knielsen/pcb_ledtorus_controller/pcb_ledtorus_controller.kicad_pcb

## KiCad design pcb_ledtorus_controller.kicad_pcb (2019-06-02)

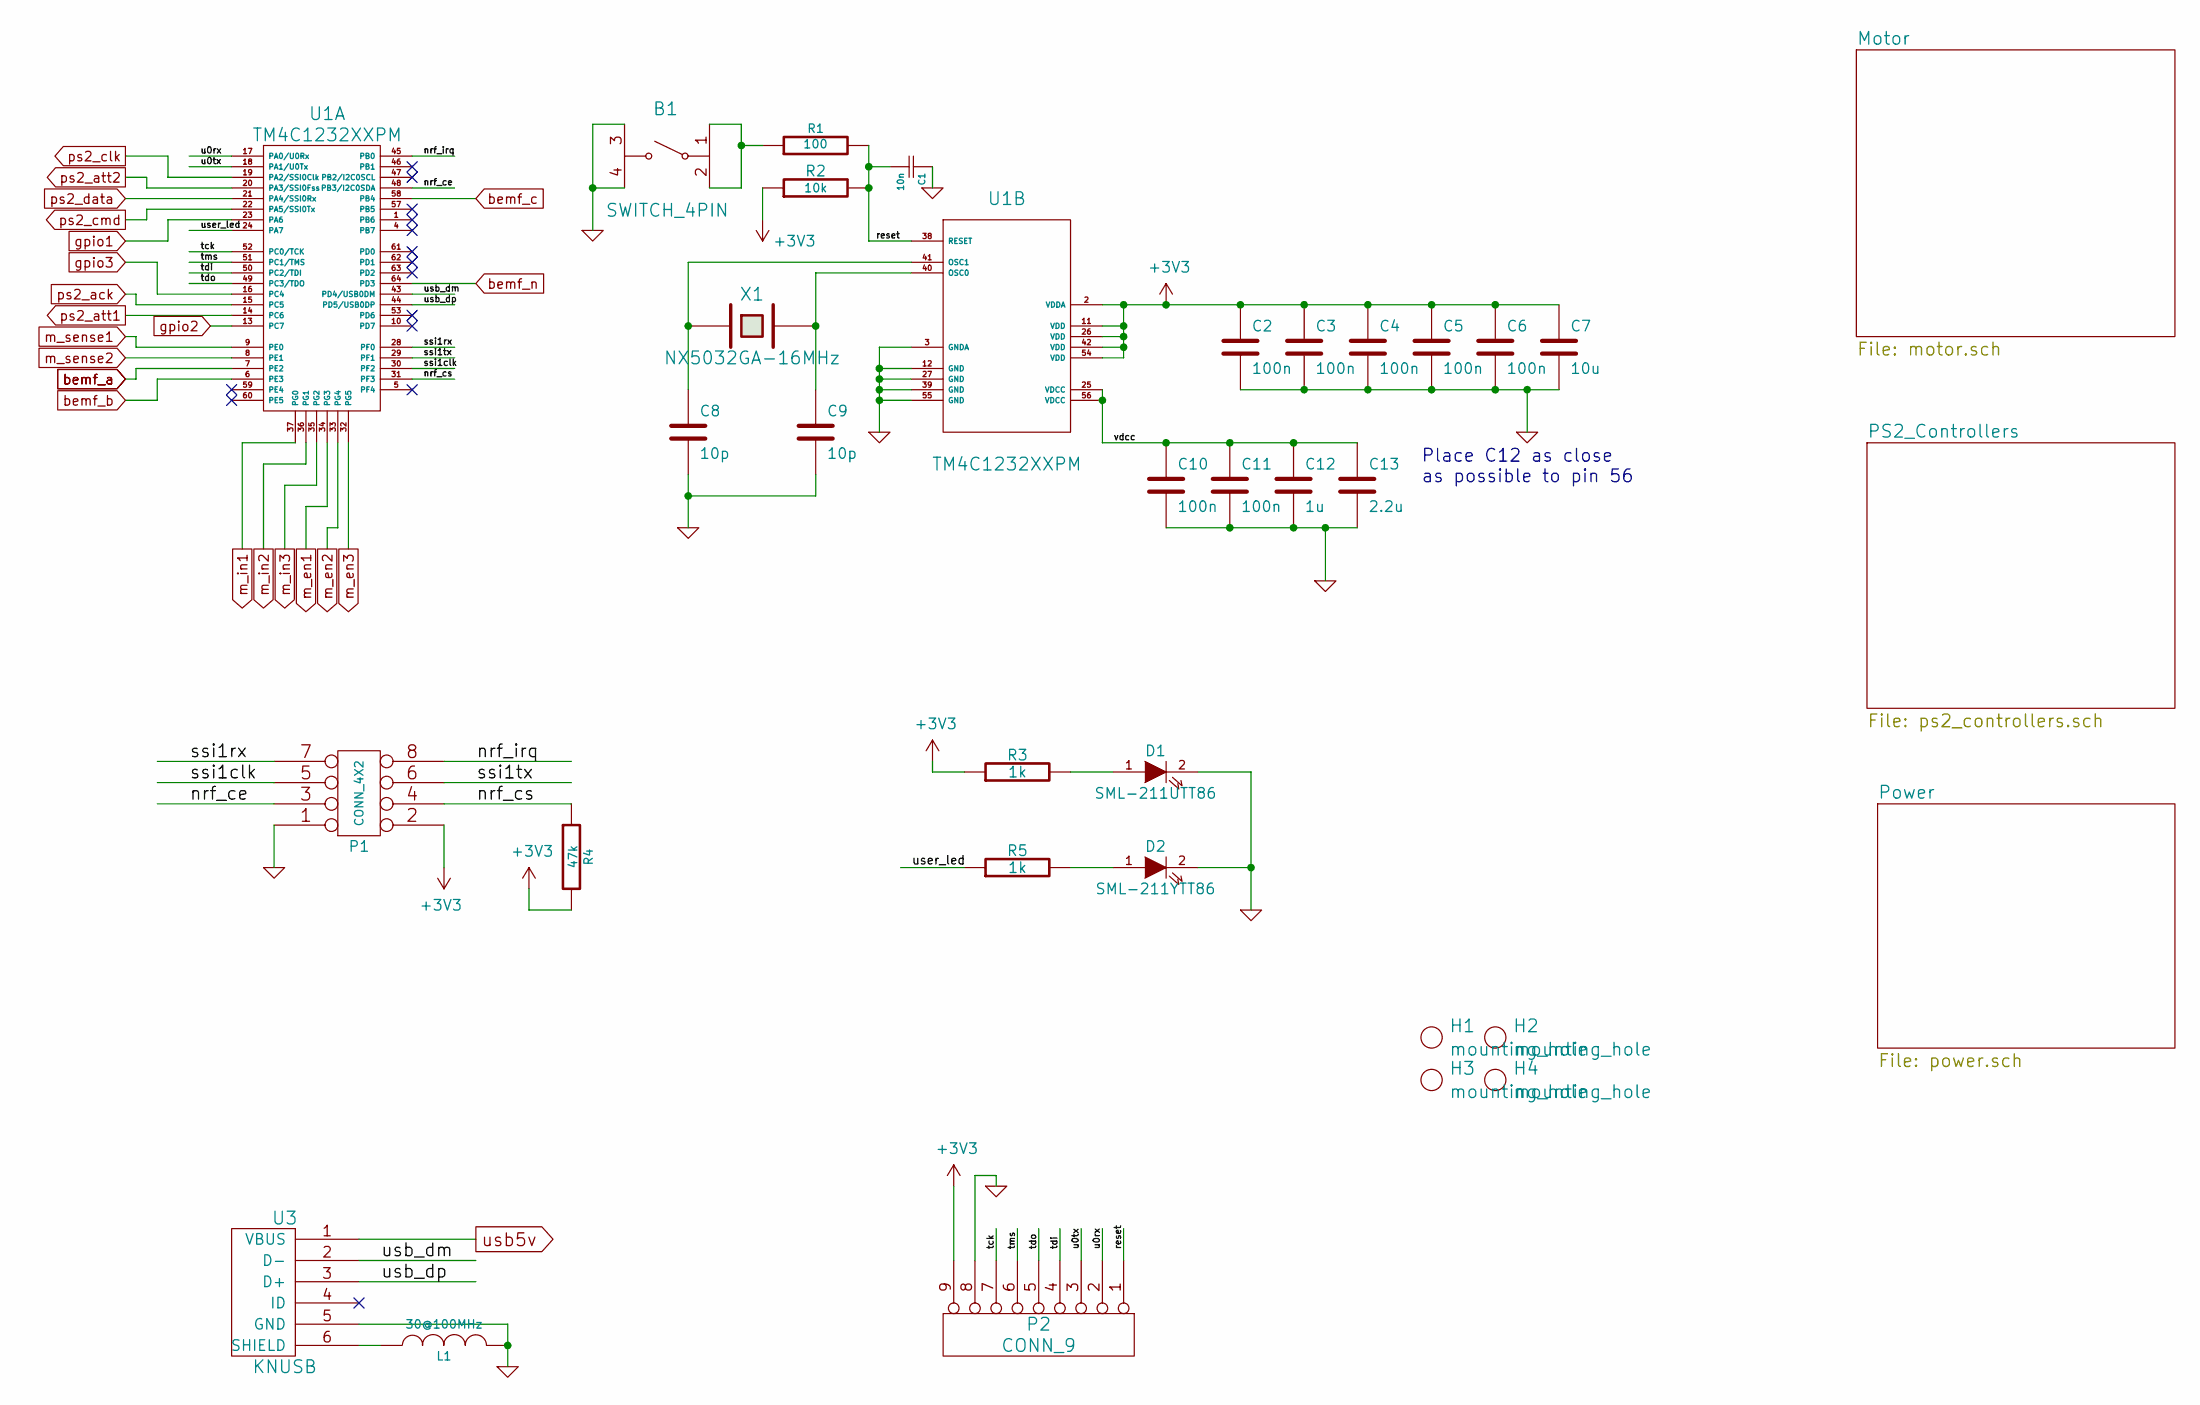
[picture p1: schematic pcb_ledtorus_controller.sch]

Parts:
B1: SWITCH_4PIN; SWITCH_FSMJSMA
C1: 10n; C_0805
C2, C3, C4, C5, C6, C10, C11: 100n; C_0603
C7: 10u; C_0805
C8, C9: 10p; C_0805
C12: 1u; C_0805
C13: 2.2u; C_0805
D1: SML-211UTT86; LED_0805
D2: SML-211YTT86; LED_0805
H1, H2, H3, H4: mounting_hole; MountingHole_4.3mm_M4
L1: 30@100MHz; L_0603
P1: CONN_4X2; Pin_Header_Straight_2x04_Pitch2.54mm
P2: CONN_9; Pin_Header_Straight_1x09_Pitch2.54mm
R1: 100; R_0805
R2: 10k; R_0805
R3, R5: 1k; R_0805
R4: 47k; R_0805
U1: TM4C1232XXPM; LQFP_64
U3: KNUSB; 10103594-0001LF
X1: NX5032GA-16MHz; NX5032GA

Connections:
+3V3: C2.1, C3.1, C4.1, C5.1, C6.1, C7.1, P1.2, P2.9, R2.1, R3.1, R4.2, U1.2 (VDDA), U1.11 (VDD), U1.26 (VDD), U1.42 (VDD), U1.54 (VDD); also elsewhere on the board
/nrf_ce: P1.3, U1.48 (PB3/I2C0SDA)
/nrf_cs: P1.4, R4.1, U1.31 (PF3)
/nrf_irq: P1.8, U1.45 (PB0)
/reset: C1.2, P2.1, R1.2, R2.2, U1.38 (RESET)
/ssi1clk: P1.5, U1.30 (PF2)
/ssi1rx: P1.7, U1.28 (PF0)
/ssi1tx: P1.6, U1.29 (PF1)
/tck: P2.7, U1.52 (PC0/TCK)
/tdi: P2.4, U1.50 (PC2/TDI)
/tdo: P2.5, U1.49 (PC3/TDO)
/tms: P2.6, U1.51 (PC1/TMS)
/u0rx: P2.2, U1.17 (PA0/U0Rx)
/u0tx: P2.3, U1.18 (PA1/U0Tx)
/usb_dm: U1.43 (PD4/USB0DM), U3.2 (D-)
/usb_dp: U1.44 (PD5/USB0DP), U3.3 (D+)
/user_led: R5.1, U1.24 (PA7)
/vdcc: C10.1, C11.1, C12.1, C13.1, U1.25 (VDCC), U1.56 (VDCC)
GND: B1.3, B1.4, C1.1, C2.2, C3.2, C4.2, C5.2, C6.2, C7.2, C8.2, C9.2, C10.2, C11.2, C12.2, C13.2, D1.2 (K), D2.2 (K), L1.2, P1.1, P2.8, U1.3 (GNDA), U1.12 (GND), U1.27 (GND), U1.39 (GND), U1.55 (GND), U3.5 (GND); also elsewhere on the board
unnamed: B1.1, B1.2, R1.1
unnamed: C8.1, U1.41 (OSC1), X1.1
unnamed: C9.1, U1.40 (OSC0), X1.2
unnamed: D1.1 (A), R3.2
unnamed: D2.1 (A), R5.2
unnamed: L1.1, U3.6 (SHIELD)
bemf_a: U1.7 (PE2); also elsewhere on the board
bemf_b: U1.6 (PE3); also elsewhere on the board
bemf_c: U1.58 (PB4); also elsewhere on the board
bemf_n: U1.64 (PD3); also elsewhere on the board
gpio1: U1.23 (PA6); also elsewhere on the board
gpio2: U1.13 (PC7); also elsewhere on the board
gpio3: U1.16 (PC4); also elsewhere on the board
m_en1: U1.34 (PG3); also elsewhere on the board
m_en2: U1.33 (PG4); also elsewhere on the board
m_en3: U1.32 (PG5); also elsewhere on the board
m_in1: U1.37 (PG0); also elsewhere on the board
m_in2: U1.36 (PG1); also elsewhere on the board
m_in3: U1.35 (PG2); also elsewhere on the board
m_sense1: U1.9 (PE0); also elsewhere on the board
m_sense2: U1.8 (PE1); also elsewhere on the board
ps2_ack: U1.15 (PC5); also elsewhere on the board
ps2_att1: U1.14 (PC6); also elsewhere on the board
ps2_att2: U1.20 (PA3/SSI0Fss); also elsewhere on the board
ps2_clk: U1.19 (PA2/SSI0Clk); also elsewhere on the board
ps2_cmd: U1.22 (PA5/SSI0Tx); also elsewhere on the board
ps2_data: U1.21 (PA4/SSI0Rx); also elsewhere on the board
usb5v: U3.1 (VBUS); also elsewhere on the board

Notes on the sheet:
Place C12 as close as possible to pin 56

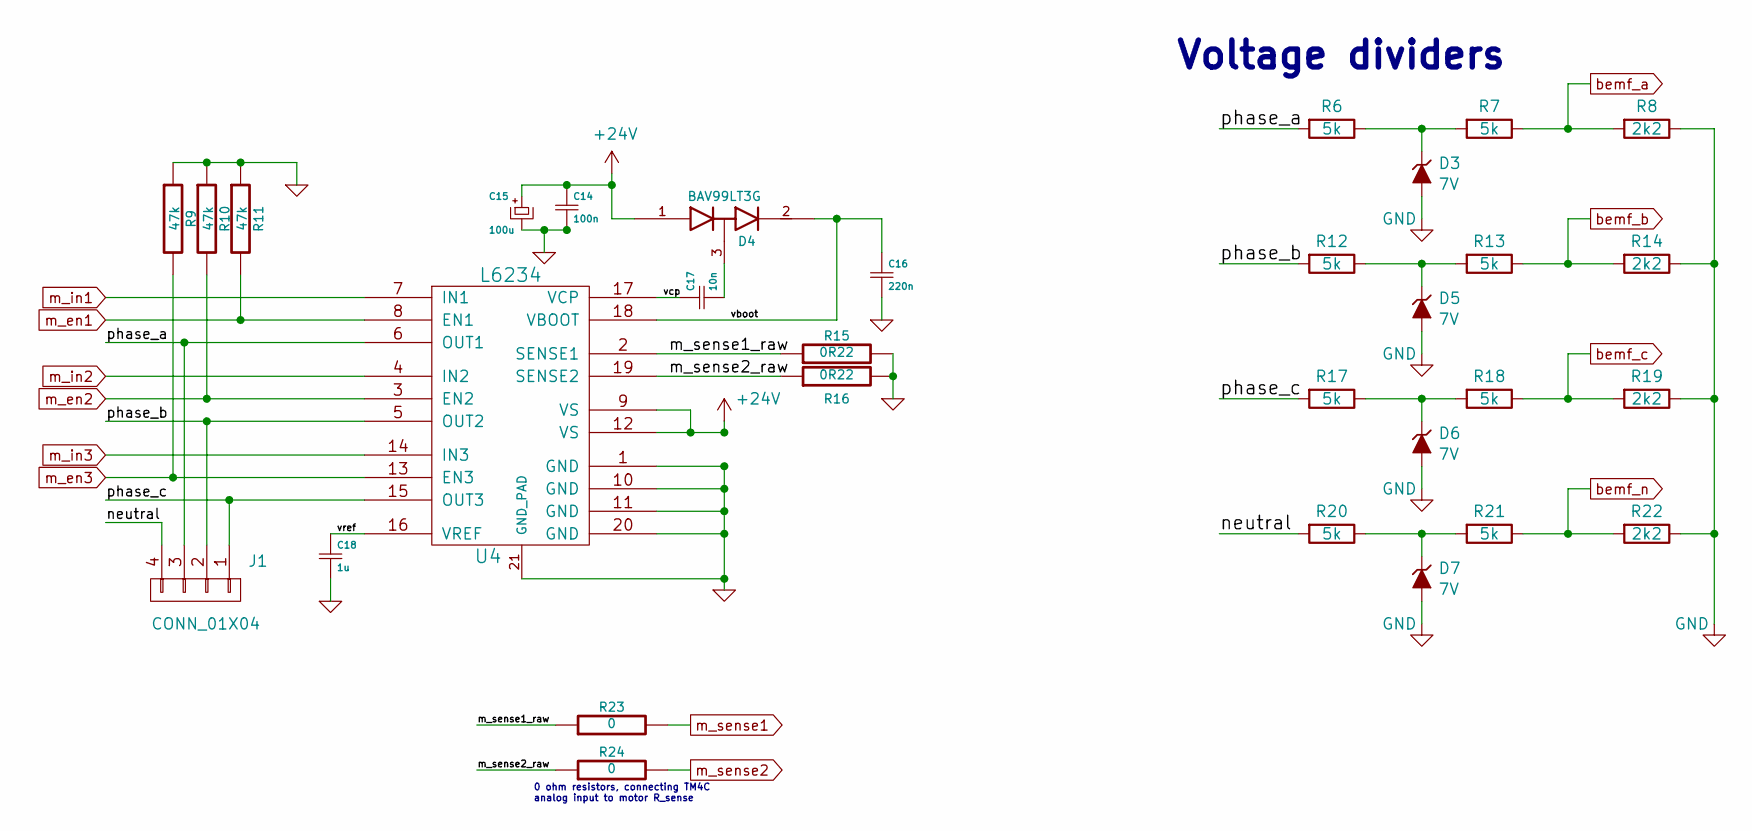
[picture p2: schematic motor.sch]

Parts:
C14: 100n; C_0603
C15: 100u; c_elec_6.3x7.7
C16: 220n; C_0805
C17: 10n; C_0805
C18: 1u; C_0805
D3, D5, D6, D7: 7V; D_SOD-123
D4: BAV99LT3G; SOT-23
J1: CONN_01X04; Pin_Header_Straight_1x04_Pitch2.54mm
R6, R7, R12, R13, R17, R18, R20, R21: 5k; R_0603
R8, R14, R19, R22: 2k2; R_0603
R9, R10, R11: 47k; R_0805
R15, R16: 0R22; R_0805
R23, R24: 0; R_0805
U4: L6234; POWERSO20_stencil

Connections:
+24V: C14.1, C15.1, D4.1 (Anode), U4.9 (VS), U4.12 (VS); also elsewhere on the board
/Motor/m_sense1_raw: R15.1, R23.1, U4.2 (SENSE1)
/Motor/m_sense2_raw: R16.1, R24.1, U4.19 (SENSE2)
/Motor/neutral: J1.4, R20.2
/Motor/phase_a: J1.3, R6.2, U4.6 (OUT1)
/Motor/phase_b: J1.2, R12.2, U4.5 (OUT2)
/Motor/phase_c: J1.1, R17.2, U4.15 (OUT3)
/Motor/vboot: C16.1, D4.2 (cathode), U4.18 (VBOOT)
/Motor/vcp: C17.1, U4.17 (VCP)
/Motor/vref: C18.1, U4.16 (VREF)
GND: C14.2, C15.2, C16.2, C18.2, D3.2 (A), D5.2 (A), D6.2 (A), D7.2 (A), R8.1, R9.1, R10.1, R11.1, R14.1, R15.2, R16.2, R19.1, R22.1, U4.1 (GND), U4.10 (GND), U4.11 (GND), U4.20 (GND), U4.21 (GND_PAD); also elsewhere on the board
unnamed: C17.2, D4.3 (AK)
unnamed: D3.1 (K), R6.1, R7.2
unnamed: D5.1 (K), R12.1, R13.2
unnamed: D6.1 (K), R17.1, R18.2
unnamed: D7.1 (K), R20.1, R21.2
bemf_a: R7.1, R8.2; also elsewhere on the board
bemf_b: R13.1, R14.2; also elsewhere on the board
bemf_c: R18.1, R19.2; also elsewhere on the board
bemf_n: R21.1, R22.2; also elsewhere on the board
m_en1: R11.2, U4.8 (EN1); also elsewhere on the board
m_en2: R10.2, U4.3 (EN2); also elsewhere on the board
m_en3: R9.2, U4.13 (EN3); also elsewhere on the board
m_in1: U4.7 (IN1); also elsewhere on the board
m_in2: U4.4 (IN2); also elsewhere on the board
m_in3: U4.14 (IN3); also elsewhere on the board
m_sense1: R23.2; also elsewhere on the board
m_sense2: R24.2; also elsewhere on the board

Notes on the sheet:
0 ohm resistors, connecting TM4C analog input to motor R_sense
Voltage dividers

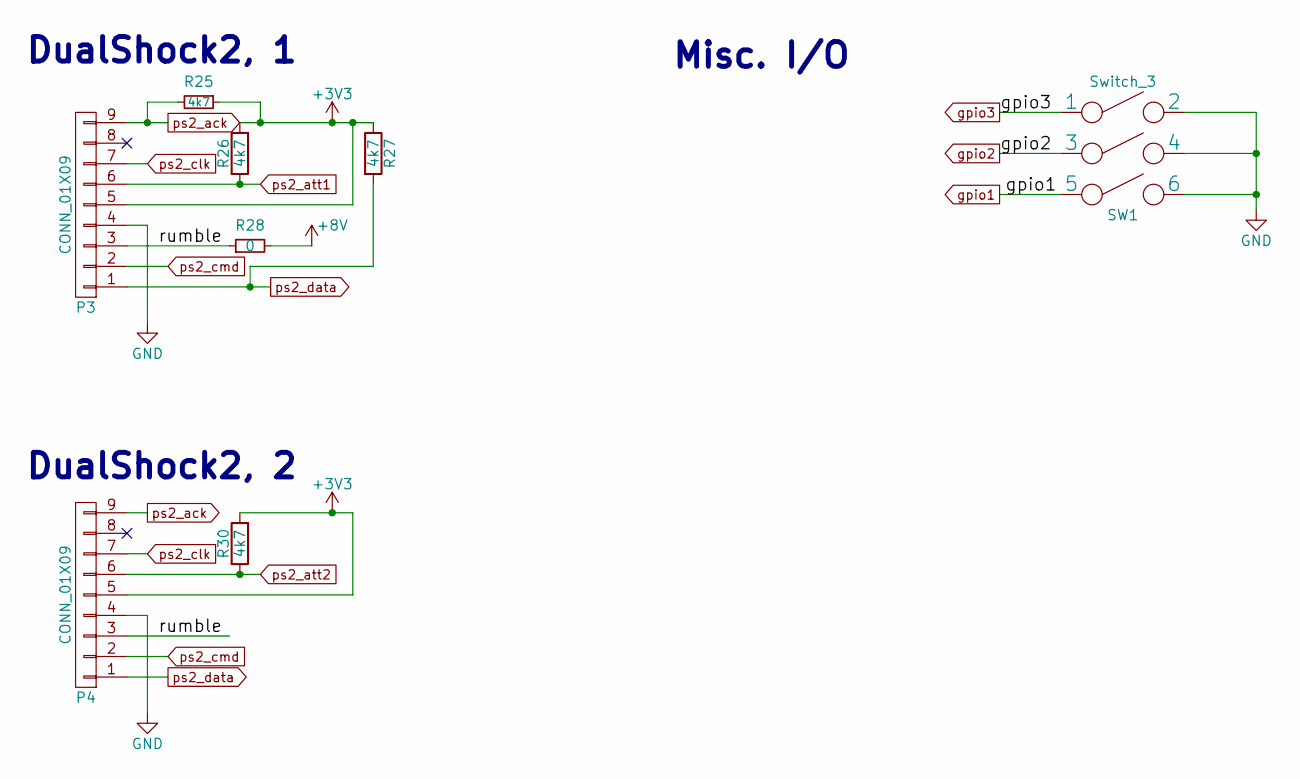
[picture p3: schematic ps2_controllers.sch]

Parts:
P3, P4: CONN_01X09; DualShock_conn
R25, R26, R27, R30: 4k7; R_0603
R28: 0; R_0805
SW1: Switch_3; DIPSWITCH_X3

Connections:
+3V3: P3.5, P4.5, R25.1, R26.2, R27.1, R30.2; also elsewhere on the board
+8V: R28.2; also elsewhere on the board
/PS2_Controllers/rumble: P3.3, P4.3, R28.1
GND: P3.4, P4.4, SW1.2, SW1.4, SW1.6; also elsewhere on the board
gpio1: SW1.5; also elsewhere on the board
gpio2: SW1.3; also elsewhere on the board
gpio3: SW1.1; also elsewhere on the board
ps2_ack: P3.9, P4.9, R25.2; also elsewhere on the board
ps2_att1: P3.6, R26.1; also elsewhere on the board
ps2_att2: P4.6, R30.1; also elsewhere on the board
ps2_clk: P3.7, P4.7; also elsewhere on the board
ps2_cmd: P3.2, P4.2; also elsewhere on the board
ps2_data: P3.1, P4.1, R27.2; also elsewhere on the board

Notes on the sheet:
DualShock2, 1
DualShock2, 2
Misc. I/O

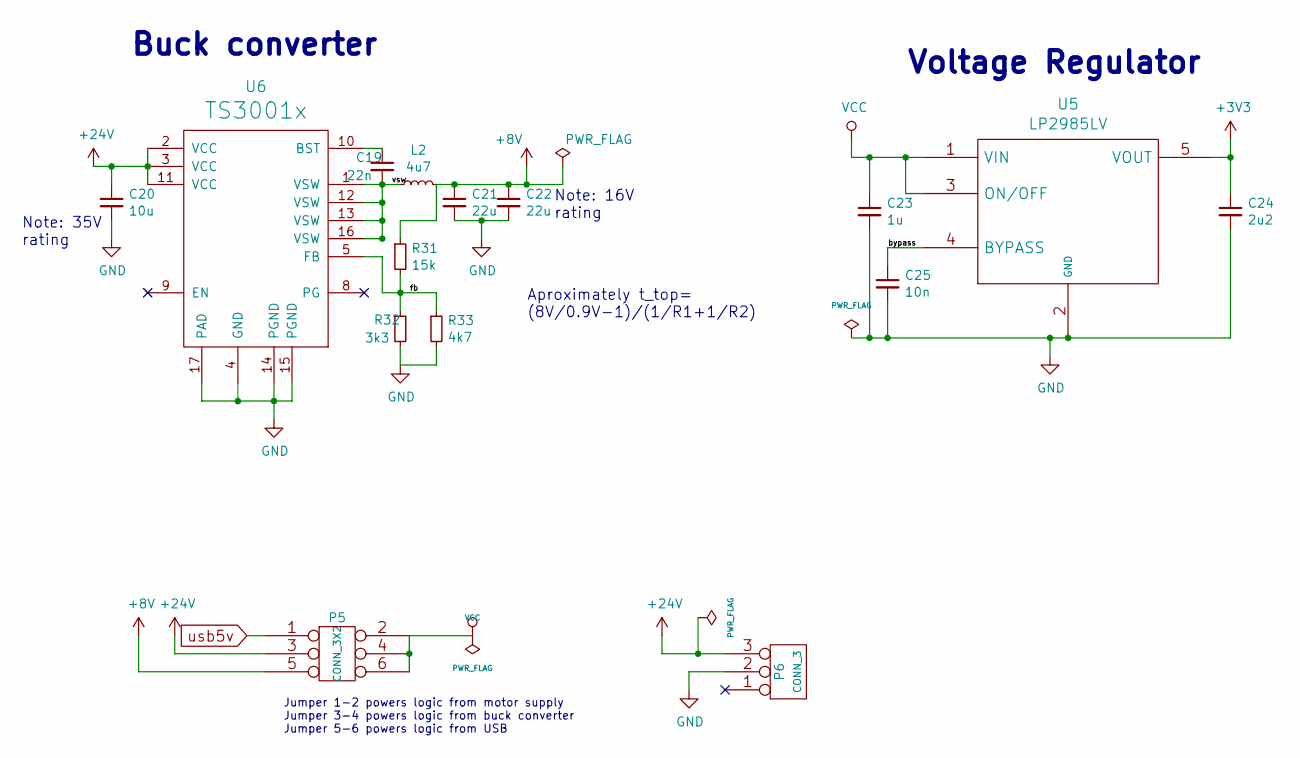
[picture p4: schematic power.sch]

Parts:
C19: 22n; C_0603
C20: 10u; C_0805
C21, C22: 22u; C_0805
C23: 1u; C_0805
C24: 2u2; C_0805
C25: 10n; C_0805
L2: 4u7; Coil_WE_7447786004
P5: CONN_3X2; Pin_Header_Straight_2x03_Pitch2.54mm
P6: CONN_3; dc_socket
R31: 15k; R_0603
R32: 3k3; R_0603
R33: 4k7; R_0603
U5: LP2985LV; SOT-23-5
U6: TS3001x; QFN16-TS30001

Connections:
+3V3: C24.1, U5.5 (VOUT); also elsewhere on the board
+8V: C21.1, C22.1, L2.2, P5.5, R31.1; also elsewhere on the board
+24V: C20.1, P5.3, P6.3, U6.2 (VCC), U6.3 (VCC), U6.11 (VCC); also elsewhere on the board
/Power/bypass: C25.1, U5.4 (BYPASS)
/Power/fb: R31.2, R32.1, R33.1, U6.5 (FB)
/Power/vsw: C19.2, L2.1, U6.1 (VSW), U6.12 (VSW), U6.13 (VSW), U6.16 (VSW)
GND: C20.2, C21.2, C22.2, C23.2, C24.2, C25.2, P6.2 (PM), R32.2, R33.2, U5.2 (GND), U6.4 (GND), U6.14 (PGND), U6.15 (PGND), U6.17 (PAD); also elsewhere on the board
unnamed: C19.1, U6.10 (BST)
VCC: C23.1, P5.2, P5.4, P5.6, U5.1 (VIN), U5.3 (ON/OFF)
usb5v: P5.1; also elsewhere on the board

Notes on the sheet:
Note: 35V rating
Note: 16V rating
Aproximately t_top= (8V/0.9V-1)/(1/R1+1/R2)
Jumper 1-2 powers logic from motor supply Jumper 3-4 powers logic from buck converter Jumper 5-6 powers logic from USB
Voltage Regulator
Buck converter

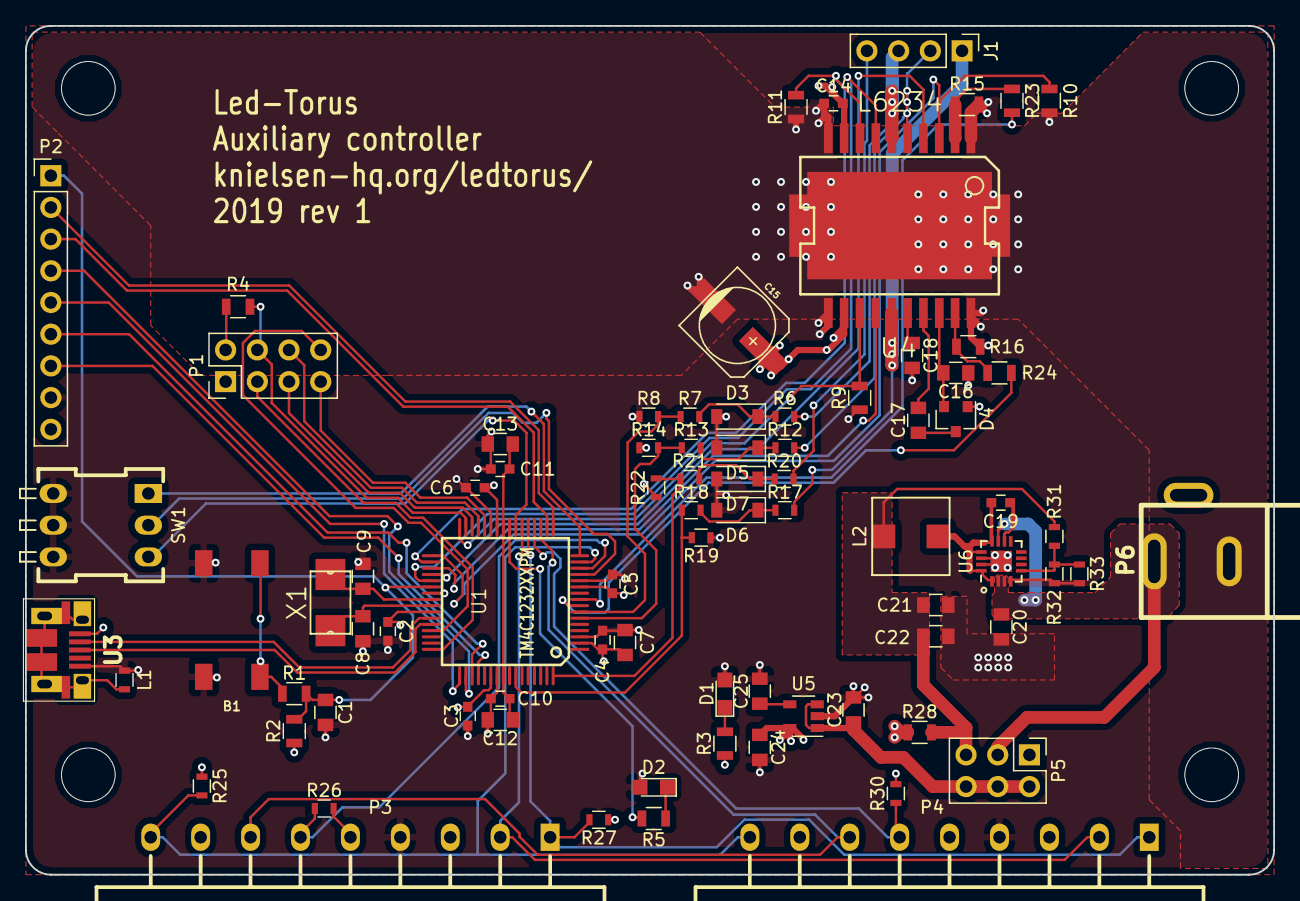
[picture p5: board pcb_ledtorus_controller.kicad_pcb from above]

Board: 4 copper layers, 100.0 x 68.0 mm, 85 parts (0 on the bottom side), 69 nets.
