knielsen/pcb_ledtorus_controller/(commit log)

2018-12-29 Partial steps towards a new controller PCB for the LED-torus
    [motor.sch, pcb_ledtorus_controller.sch, power.sch, ps2_controllers.sch]
2018-12-29 Passing ERC
    [motor.sch, pcb_ledtorus_controller.sch, power.sch, ps2_controllers.sch]
2018-12-29 Starting on netlist
    [motor.sch, pcb_ledtorus_controller.kicad_pcb, pcb_ledtorus_controller.sch, power.sch, ps2_controllers.sch]
2018-12-30 Work on layout
    [motor.sch, pcb_ledtorus_controller.kicad_pcb, pcb_ledtorus_controller.sch, power.sch, ps2_controllers.sch]
2019-03-04 Initial routing complete
    [pcb_ledtorus_controller.kicad_pcb]
2019-03-17 Completing cleanups and ToDos:
    - L6234 thermal vias done
    - Gerbers checked
    - Misc. io and stuff tweaks
    [pcb_ledtorus_controller.kicad_pcb, pcb_ledtorus_controller.sch, power.sch, ps2_controllers.sch]
2019-06-02 Submitted rev1 for production @ SeeedStudio
    [motor.sch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]
